0xCB-dev/0xCB-Jupiter/v0.2/switchplate/Switch plate.DXF

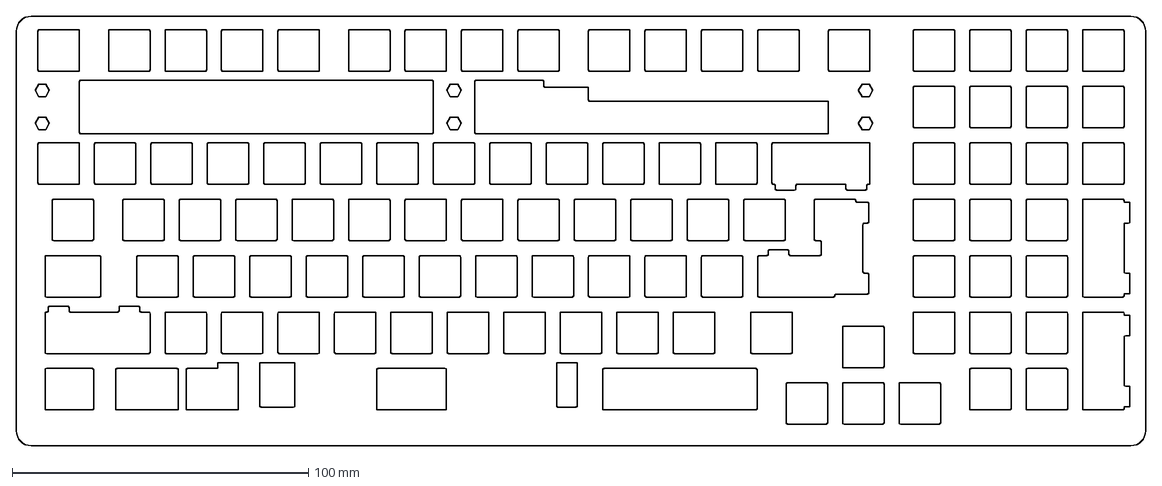
[picture p1: CAD file, 2022-03-01]
v0.2/switchplate/Switch plate.DXF
381.0 x 144.9 mm
