0xCB-dev/0xCB-Jupiter/(commit log)

2022-02-02 Start PCB project
    [pcb.kicad_pcb, pcb.kicad_sch]
2022-02-02 Main PBC components
    [pcb.kicad_sch]
2022-02-03 Wired duplex matrix
    [pcb.kicad_sch]
2022-02-03 Redid wiring on schematic because I hate myself
    [pcb.kicad_pcb, pcb.kicad_sch]
2022-02-04 Main wiring schematic finally done, keys organized on PCB
    [pcb.kicad_pcb, pcb.kicad_sch]
2022-02-04 PCB components placed
    [pcb.kicad_pcb, pcb.kicad_sch]
2022-02-05 Routed diodes
    [pcb.kicad_pcb]
2022-02-06 God help me with these diodes
    [pcb.kicad_pcb, pcb.kicad_sch]
2022-02-06 Removed tracks to start over, i cri
    [pcb.kicad_pcb]
2022-02-11 Started routing of rows
    [pcb.kicad_pcb, pcb.kicad_sch]
2022-02-11 Started routing of rows 2
    [pcb.kicad_pcb]
2022-02-11 Routing rows 3
    [pcb.kicad_pcb]
2022-02-11 Routing rows 4
    [pcb.kicad_pcb]
2022-02-11 Routing rows 5
    [pcb.kicad_pcb]
2022-02-12 Routing rows 6
    [pcb.kicad_pcb]
2022-02-12 Routing rows 7
    [pcb.kicad_pcb, pcb.kicad_sch]
2022-02-13 Routing rows 8
    [pcb.kicad_pcb]
2022-02-15 routing rows 9
    [pcb.kicad_pcb]
2022-02-15 Routing more than just rows 1
    [pcb.kicad_pcb, pcb.kicad_sch]
2022-02-15 Main routing 2
    [pcb.kicad_pcb]
2022-02-15 Finished first routing attempt
    [pcb.kicad_pcb, pcb.kicad_sch]
2022-02-26 Rerouted components at the top
    [pcb.kicad_pcb]
2022-02-26 Fill and first gerbers
    [pcb-B_Cu.gbr, pcb-B_Mask.gbr, pcb-B_Paste.gbr, pcb-B_Silkscreen.gbr, pcb-Edge_Cuts.gbr, pcb-F_Cu.gbr, pcb-F_Mask.gbr, pcb-F_Paste.gbr]
2022-02-26 Fixed 6u spacebar
    [pcb.kicad_sch]
2022-02-28 Removed some footprints, rerouted some traces
2022-02-28 Added backplate w/ mount holes for board and feet
    [backplate.kicad_pcb, backplate.kicad_sch]
2022-02-28 fixed some minor things
    [backplate.kicad_pcb]
2022-03-01 added switch plate
    [Switch plate.DXF]
2022-03-01 PCB art, keyboard name under spacebar
    [pcb.kicad_sch]
2022-03-01 Fix diode silkscreen
2022-03-01 Fixed components silkscreen
2022-03-01 Fix silkscreen II
2022-03-01 Switch plate KiCad files
    [switchplate.kicad_pcb, switchplate.kicad_sch]
2022-03-02 Added copper fill to switchplate
    [switchplate.kicad_pcb]
2022-03-02 Added gerbers
    [backplate-B_Cu.gbr, backplate-B_Mask.gbr, backplate-B_Paste.gbr, backplate-B_Silkscreen.gbr, backplate-Edge_Cuts.gbr, backplate-F_Cu.gbr, backplate-F_Mask.gbr, backplate-F_Paste.gbr]
2022-03-04 Cleaned up traces, fixed fill tolerances
2022-03-06 pcb cleanup
2022-03-07 GND mounting holes
2022-03-14 cleanup PCB finished
2022-03-15 New gerbers, interactive BOM
    [backplate-B_Cu.gbr, backplate-B_Mask.gbr, backplate-B_Paste.gbr, backplate-B_Silkscreen.gbr, backplate-Edge_Cuts.gbr, backplate-F_Cu.gbr, backplate-F_Mask.gbr, backplate-F_Paste.gbr]
2022-04-16 Update location of VCC capacitors
2022-04-16 Reroute ROW2 switches
    [pcb.kicad_sch]
2022-04-20 Fixed top window mounting holes
2022-04-21 Replaced switch footprints
    Need to still add the correct 6u spacebar footprint
    [pcb.kicad_sch]
2022-04-22 Regenerate PCB gerbers
    [pcb-B_Cu.gbr, pcb-B_Mask.gbr, pcb-B_Paste.gbr, pcb-B_Silkscreen.gbr, pcb-Edge_Cuts.gbr, pcb-F_Cu.gbr, pcb-F_Mask.gbr, pcb-F_Paste.gbr]
2022-04-22 Rename of folders to Jupiter
    [backplate-B_Cu.gbr, backplate-B_Mask.gbr, backplate-B_Paste.gbr, backplate-B_Silkscreen.gbr, backplate-Edge_Cuts.gbr, backplate-F_Cu.gbr, backplate-F_Mask.gbr, backplate-F_Paste.gbr]
2022-04-24 Added capacitor polarity marking
    [pcb.kicad_sch]
2022-05-01 Added 6U offset spacebar to PCB
    Still need to add the cutout for the 6U offset spacebar switch to the switchplate.
    [pcb.kicad_sch, switchplate.kicad_pcb]
2022-05-01 Moved top window support holes on backplate
    [backplate.kicad_pcb]
2022-05-04 Updated 6u and 6u offset footprint to 0xCB
    [pcb.kicad_sch]
2022-06-04 Started work on v0.2
    Changed layout to support original G80-1800 layout and 10u spacebar - removed all wiring in preparation for rewire and changing controller to Black Pill
    [Switch plate.DXF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]
2022-06-12 Updated schematic, add temp controller footprint
    [pcb.kicad_pcb, pcb.kicad_sch]
2022-06-13 Change footprint to 0xCB lib, add basic outline
    [pcb.kicad_pcb, pcb.kicad_sch]
2022-06-14 Removed OG 6u layout
    [pcb.kicad_sch]
2022-06-14 Routing PCB, added extra layouts
    [pcb.kicad_pcb, pcb.kicad_sch]
2022-06-15 Finish routing diodes
2022-06-16 Routed rows and columns to controller
    [pcb.kicad_sch]
2022-06-20 Add screw holes, update bottom plate
    [backplate-B_Cu.gbr, backplate-B_Mask.gbr, backplate-B_Paste.gbr, backplate-B_Silkscreen.gbr, backplate-Edge_Cuts.gbr, backplate-F_Cu.gbr, backplate-F_Mask.gbr, backplate-F_Paste.gbr]
